thetaspirit/remigochi-pcb/ESD122DMXR.step

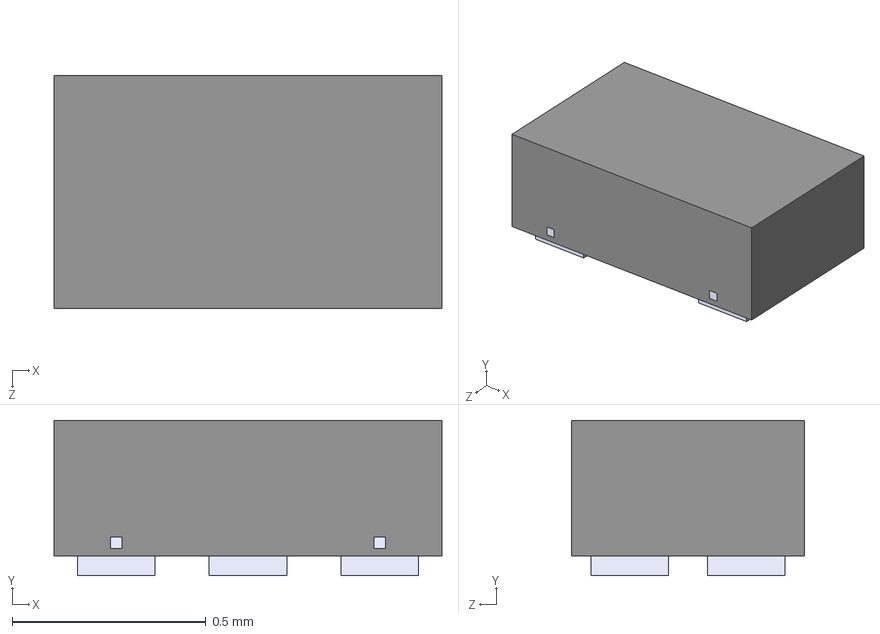
[picture p1: CAD file, 2026-04-01]
ESD122DMXR.step
1.00 x 0.4 x 0.6 mm
