thetaspirit/remigochi-pcb/TF-01A.step

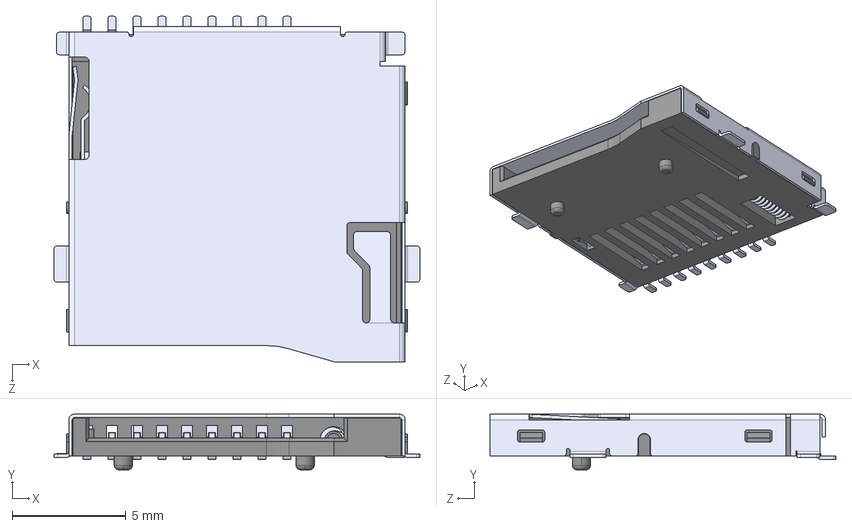
[picture p2: CAD file, 2026-02-19]
TF-01A.step
16.1 x 2.45 x 15.2 mm
