thetaspirit/remigochi-pcb/remigochi-pcb.kicad_pcb

## KiCad design remigochi-pcb.kicad_pcb (2026-04-06)

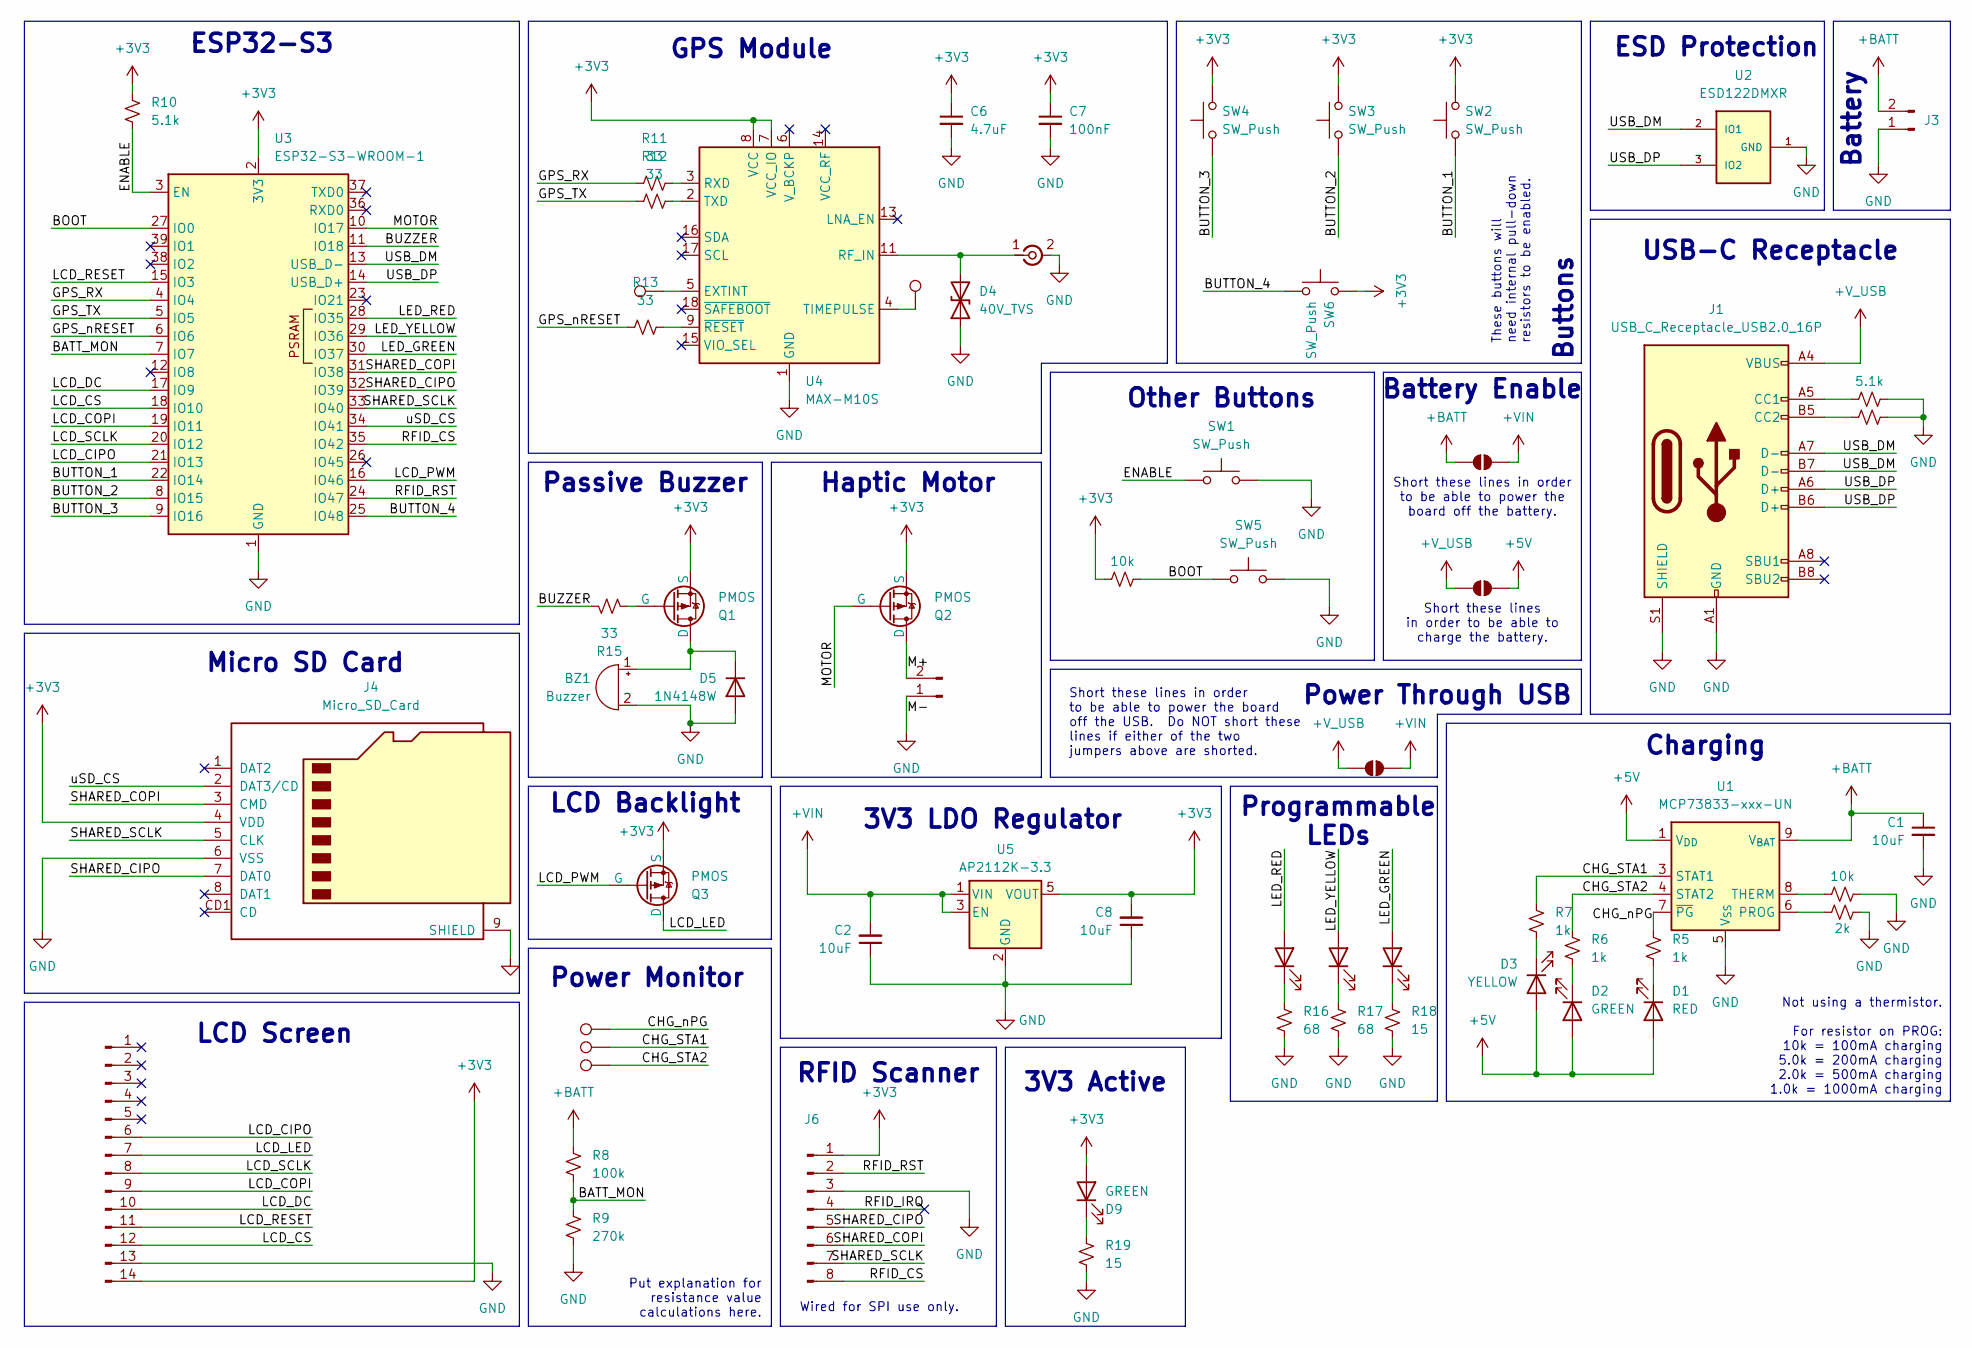
[picture p3: schematic remigochi-pcb.kicad_sch]

Parts:
BZ1: Buzzer; Huaneng MLT-7525; LCSC Part Number C95299
C1, C2, C8: 10uF; C_0603_1608Metric; LCSC Part Number C19702
C6: 4.7uF; C_0603_1608Metric; LCSC Part Number C19666
C7: 100nF; C_0603_1608Metric; LCSC Part Number C14663
D1, D8: RED; D_1206_3216Metric; LCSC Part Number C2984265
D2, D7, D9: GREEN; D_1206_3216Metric; LCSC Part Number C965825
D3, D6: YELLOW; D_1206_3216Metric; LCSC Part Number C1322289
D4: 40V_TVS; D_0402_1005Metric; LCSC Part Number C10662
D5: 1N4148W; D_SOD-123; LCSC Part Number C241939
J1: USB_C_Receptacle_USB2.0_16P; USB_C_Receptacle_G-Switch_GT-USB-7010ASV; LCSC Part Number C2988369
J2: Conn_01x02_Pin; PinHeader_1x02_P2.54mm_Vertical
J3: Conn_01x02_Pin; SolderWire-1.5sqmm_1x02_P6mm_D1.7mm_OD3mm_Relief
J4: Micro_SD_Card; TF-01A; LCSC Part Number C20613191
J5: Conn_Coaxial_Small; U.FL_Hirose_U.FL-R-SMT-1_Vertical; LCSC Part Number C88374
J6: Conn_01x08_Pin; PinHeader_1x08_P2.54mm_Vertical
J9: Conn_01x14_Pin; PinHeader_1x14_P2.54mm_Vertical
JP2, JP6, JP8: SolderJumper_2_Open; SolderJumper-2_P1.3mm_Open_RoundedPad1.0x1.5mm
Q1, Q2, Q3: PMOS; SOT-23; LCSC Part Number C10487
R1, R2, R10: 5.1k; R_0402_1005Metric; LCSC Part Number C105872
R3, R14: 10k; R_0402_1005Metric; LCSC Part Number C60490
R4: 2k; R_0402_1005Metric; LCSC Part Number C60488
R5, R6, R7: 1k; R_0402_1005Metric; LCSC Part Number C106235
R8: 100k; R_0402_1005Metric; LCSC Part Number C60491
R9: 270k; R_0402_1005Metric; LCSC Part Number C163475
R11, R12, R13, R15: 33; R_0402_1005Metric; LCSC Part Number C138002
R16, R17: 68; R_0402_1005Metric; LCSC Part Number C2909380
R18, R19: 15; R_0402_1005Metric; LCSC Part Number C138052
SW1, SW2, SW3, SW4, SW5, SW6: SW_Push; Korean Hroparts Elec K2-1157SP-I4SW-01; LCSC Part Number C2909692
TP1, TP2, TP7, TP8, TP9: TestPoint; TestPoint_Pad_D1.0mm
U1: MCP73833-xxx-UN; MSOP-10_3x3mm_P0.5mm; LCSC Part Number C627668
U2: ESD122DMXR; IC_ESD122DMXR; PARTREV A; LCSC Part Number C544474
U3: ESP32-S3-WROOM-1; LCSC Part Number C2913197
U4: MAX-M10S; ublox_MAX; LCSC Part Number C4153167
U5: AP2112K-3.3; SOT-23-5; LCSC Part Number C23380830

Connections:
+3V3: C6.1, C7.1, C8.2, D9.2 (A), J4.4 (VDD), J6.1, J9.14, Q1.2 (S), Q2.2 (S), Q3.2 (S), R10.1, R14.1, SW2.2, SW3.2, SW4.2, SW6.2, U3.2 (3V3), U4.7 (VCC_IO), U4.8 (VCC), U5.5 (VOUT)
+5V: D1.2 (A), D2.2 (A), D3.2 (A), JP2.2 (B), U1.1 (V_{DD}), U1.2 (V_{DD})
+BATT: C1.1, J3.2, JP6.1 (A), R8.1, U1.9 (V_{BAT}), U1.10 (V_{BAT})
+VIN: C2.2, JP6.2 (B), JP8.2 (B), U5.1 (VIN), U5.3 (EN)
+V_USB: J1.A4 (VBUS), J1.A9 (VBUS), J1.B4 (VBUS), J1.B9 (VBUS), JP2.1 (A), JP8.1 (A)
/BATT_MON: R8.2, R9.1, U3.7 (IO7)
/BOOT: R14.2, SW5.1, U3.27 (IO0)
/BUTTON_1: SW2.1, U3.22 (IO14)
/BUTTON_2: SW3.1, U3.8 (IO15)
/BUTTON_3: SW4.1, U3.9 (IO16)
/BUTTON_4: SW6.1, U3.25 (IO48)
/BUZZER: R15.1, U3.11 (IO18)
/CHG_STA1: R7.1, TP8.1 (1_1), U1.3 (STAT1)
/CHG_STA2: R6.2, TP9.1 (1_1), U1.4 (STAT2)
/CHG_nPG: R5.2, TP7.1 (1_1), U1.7 (~PG)
/ENABLE: R10.2, SW1.1, U3.3 (EN)
/GPS_RX: R11.1, U3.4 (IO4)
/GPS_TX: R12.1, U3.5 (IO5)
/GPS_nRESET: R13.1, U3.6 (IO6)
/LCD_CIPO: J9.6, U3.21 (IO13)
/LCD_COPI: J9.9, U3.19 (IO11)
/LCD_CS: J9.12, U3.18 (IO10)
/LCD_DC: J9.10, U3.17 (IO9)
/LCD_LED: J9.7, Q3.3 (D)
/LCD_PWM: Q3.1 (G), U3.16 (IO46)
/LCD_RESET: J9.11, U3.15 (IO3)
/LCD_SCLK: J9.8, U3.20 (IO12)
/LED_GREEN: D7.2 (A), U3.30 (IO37)
/LED_RED: D8.2 (A), U3.28 (IO35)
/LED_YELLOW: D6.2 (A), U3.29 (IO36)
/M+: J2.2, Q2.3 (D)
/MOTOR: Q2.1 (G), U3.10 (IO17)
/RFID_CS: J6.8, U3.35 (IO42)
/RFID_IRQ: J6.4
/RFID_RST: J6.2, U3.24 (IO47)
/SHARED_CIPO: J4.7 (DAT0), J6.5, U3.32 (IO39)
/SHARED_COPI: J4.3 (CMD), J6.6, U3.31 (IO38)
/SHARED_SCLK: J4.5 (CLK), J6.7, U3.33 (IO40)
/USB_DM: J1.A7 (D-), J1.B7 (D-), U2.2 (IO1), U3.13 (USB_D-)
/USB_DP: J1.A6 (D+), J1.B6 (D+), U2.3 (IO2), U3.14 (USB_D+)
/uSD_CS: J4.2 (DAT3/CD), U3.34 (IO41)
GND: BZ1.2 (-), C1.2, C2.1, C6.2, C7.2, C8.1, D4.1 (A1), D5.2 (A), J1.A1 (GND), J1.A12 (GND), J1.B1 (GND), J1.B12 (GND), J1.S1 (SHIELD), J2.1, J3.1, J4.6 (VSS), J4.9 (SHIELD), J5.2 (Ext), J6.3, J9.13, R1.2, R2.2, R3.2, R4.2, R9.2, R16.2, R17.2, R18.2, R19.2, SW1.2, SW5.2, U1.5 (V_{SS}), U2.1 (GND), U3.1 (GND), U3.40 (GND), U3.41 (GND), U4.1 (GND), U4.10 (GND), U4.12 (GND), U5.2 (GND)
unnamed: BZ1.1 (+), D5.1 (K), Q1.3 (D)
unnamed: D1.1 (K), R5.1
unnamed: D2.1 (K), R6.1
unnamed: D3.1 (K), R7.2
unnamed: D4.2 (A2), J5.1 (In), U4.11 (RF_IN)
unnamed: D6.1 (K), R17.1
unnamed: D7.1 (K), R18.1
unnamed: D8.1 (K), R16.1
unnamed: D9.1 (K), R19.1
unnamed: J1.A5 (CC1), R1.1
unnamed: J1.B5 (CC2), R2.1
unnamed: Q1.1 (G), R15.2
unnamed: R4.1, U1.6 (PROG)
unnamed: R3.1, U1.8 (THERM)
unnamed: TP1.1 (1_1), U4.5 (EXTINT)
unnamed: R11.2, U4.3 (RXD)
unnamed: TP2.1 (1_1), U4.4 (TIMEPULSE)
unnamed: R12.2, U4.2 (TXD)
unnamed: R13.2, U4.9 (~RESET)

Notes on the sheet:
Other Buttons
Passive Buzzer
USB-C Receptacle
ESD Protection
Programmable LEDs
Short these lines in order to be able to charge the battery.
These buttons will need internal pull-down resistors to be enabled.
Charging
LCD Backlight
Buttons
RFID Scanner
ESP32-S3
3V3 LDO Regulator
Power Monitor
Short these lines in order to be able to power the board off the USB. Do NOT short these lines if either of the two jumpers above are shorted.
3V3 Active
Not using a thermistor. For resistor on PROG: 10k = 100mA charging 5.0k = 200mA charging 2.0k = 500mA charging 1.0k = 1000mA charging
Power Through USB
Micro SD Card
Battery
Put explanation for resistance value calculations here.
Haptic Motor
Battery Enable
LCD Screen
Short these lines in order to be able to power the board off the battery.
Wired for SPI use only.
GPS Module

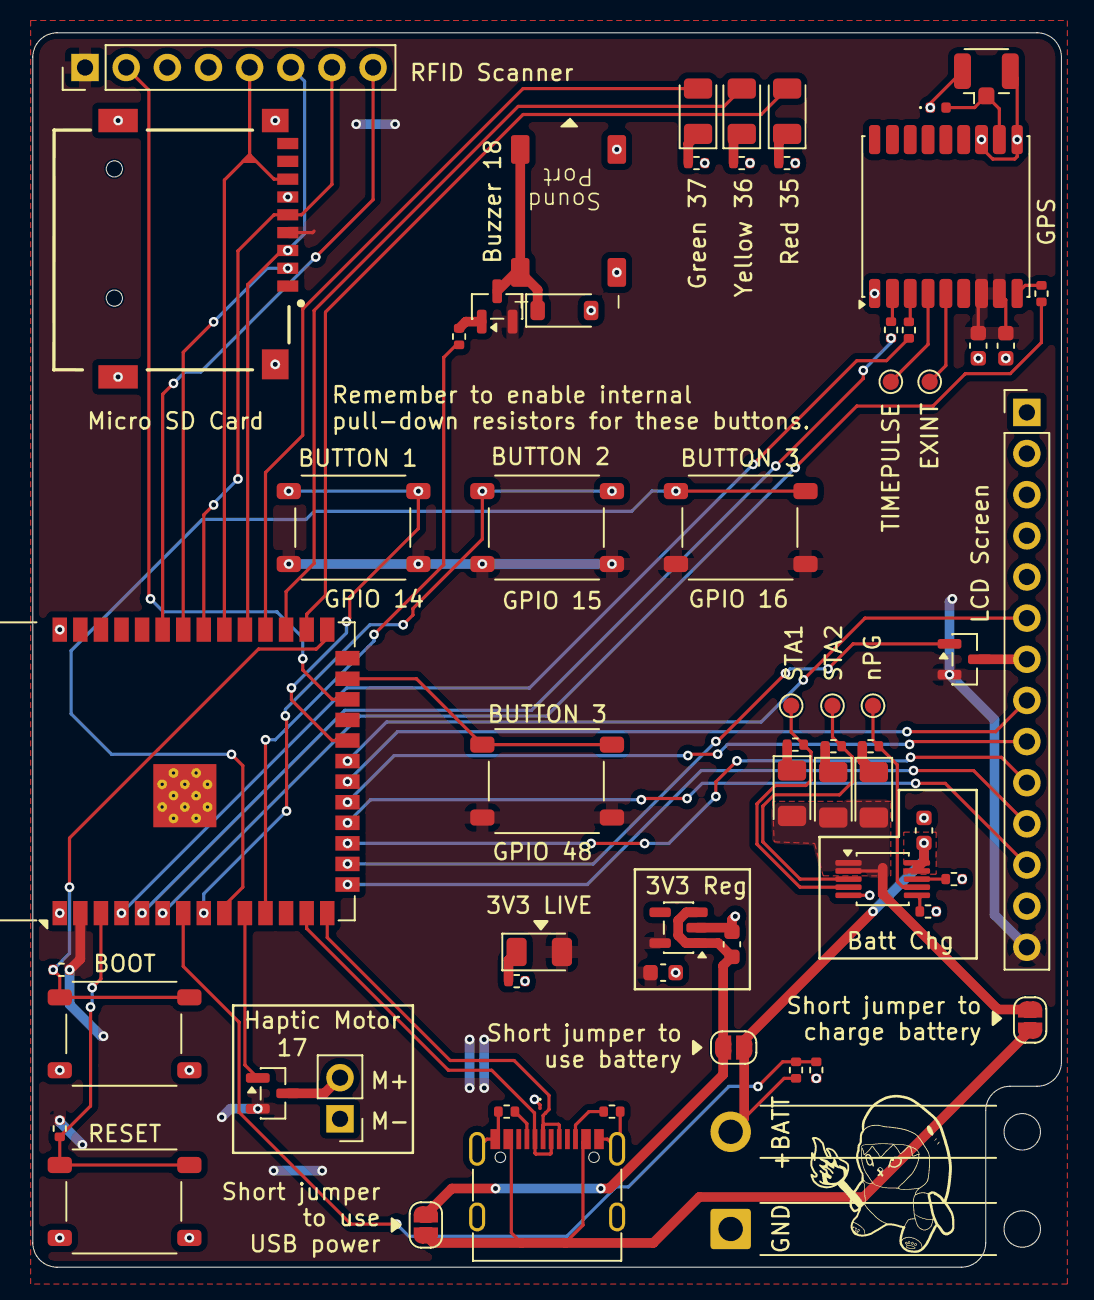
[picture p4: board remigochi-pcb.kicad_pcb from above]

Board: 2 copper layers, 63.5 x 76.2 mm, 63 parts (0 on the bottom side), 60 nets.
