thetaspirit/remigochi-pcb/(commit log)

2026-02-12 added battery and USB circuitry
    [remigochi-pcb.kicad_pcb, remigochi-pcb.kicad_sch]
2026-02-14 added esp32 and some other stuff to schematic
    [remigochi-pcb.kicad_sch]
2026-02-16 added microSD card to schematic. wip gps
    added fp-info-cache to ignore.
    [remigochi-pcb.kicad_sch]
2026-02-18 added buzzer and motor, modified GPS
    GPS still needs modifications, still have a few more subsystems to add
    to pcb
    [remigochi-pcb.kicad_sch]
2026-02-19 redid SPI pins, started adding breakout pins
    [remigochi-pcb.kicad_sch]
2026-02-19 added/rearranged missing GPIO pins
    added some of the footprints
    [TF-01A.step, remigochi-pcb.kicad_sch]
2026-02-23 added all footprints
    * passes ERC! (no errors, but some warnings)
    * schematic could possibly still need minor edits.
    * added custom footprint libraries.
    * added flyback diode to buzzer.
    [remigochi-pcb.kicad_sch]
2026-02-23 changed TVS diode footprint (and actual part)
    [remigochi-pcb.kicad_sch]
2026-02-23 WIP layout, started arranging stuff
    [remigochi-pcb.kicad_pcb, remigochi-pcb.kicad_sch]
2026-02-23 minor edits to schematic, WIP placement for layout
    * changed buck reg to LDO bc i finally decided the minimum input
    voltage on the buck was too high.
    * connected LCD_ENABLE pin to a gpio pin (oops)
    * placed stuff, almost done with placement, should start routing soon.
    [remigochi-pcb.kicad_pcb, remigochi-pcb.kicad_sch]
2026-02-24 layout done
    added LCSC numbers to bom
    still need to do silkscreen
    [remigochi-pcb.kicad_pcb, remigochi-pcb.kicad_sch]
2026-02-24 layout actually passes DRC now lol
    WIP silkscreens
    [remigochi-pcb.kicad_pcb]
2026-02-25 finished silkscreen
    [remigochi-pcb.kicad_pcb]
2026-02-25 fixed 3v3 planes being disconnected
    [remigochi-pcb.kicad_pcb]
2026-02-25 added manufacturing and assembly files
    placed our first order!!!
    [lcsc-bom.csv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]
2026-03-31 deleted manufacturing files in root directory
    [remigochi-pcb-B_Cu.gbl, remigochi-pcb-B_Mask.gbs, remigochi-pcb-B_Paste.gbp, remigochi-pcb-B_Silkscreen.gbo, remigochi-pcb-Edge_Cuts.gm1, remigochi-pcb-F_Cu.gtl, remigochi-pcb-F_Mask.gts, remigochi-pcb-F_Paste.gtp]
2026-04-01 changed nmos to pmos, added power config jumpers
    [remigochi-pcb.kicad_sch]
2026-04-01 added ESD to the USB, removed jumpers
    [ESD122DMXR.step, remigochi-pcb.kicad_sch]
2026-04-01 added led indicating battery connected
    [remigochi-pcb.kicad_sch]
2026-04-02 WIP layout
    [remigochi-pcb.kicad_pcb, remigochi-pcb.kicad_sch]
2026-04-03 fix: connected RFID to CS pin
    renamed some lines
    [remigochi-pcb.kicad_sch]
2026-04-03 placement mostly done
    [remigochi-pcb.kicad_pcb, remigochi-pcb.kicad_sch]
2026-04-04 placement and board shape done
    ready for routing
    [remigochi-pcb.kicad_pcb, remigochi-pcb.kicad_sch]
2026-04-05 routing mostly done, saving as checkpoint
    for some reason the nets/connections are fucked up somehow.
    might redo layout completely cuz idk how that happened.
    [remigochi-pcb.kicad_pcb]
2026-04-05 layout done, drc passes
    prepare BOM then send to JLC
    [remigochi-pcb.kicad_pcb]
2026-04-06 rev 2 sent off for manufacturing and assembly.
    [jlc-bom.csv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]
